buddhiheshan/aes-accelerator/docs/presentation.pdf

# RISC-V Based AES

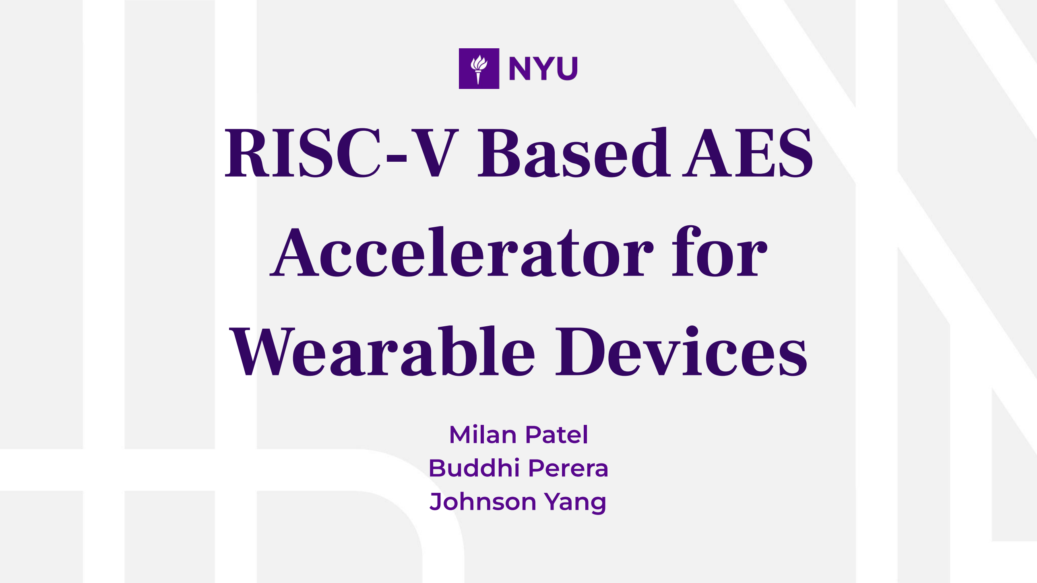
[picture p3: page 1]

# Accelerator for Wearable Devices

### Milan Patel Buddhi Perera Johnson Yang

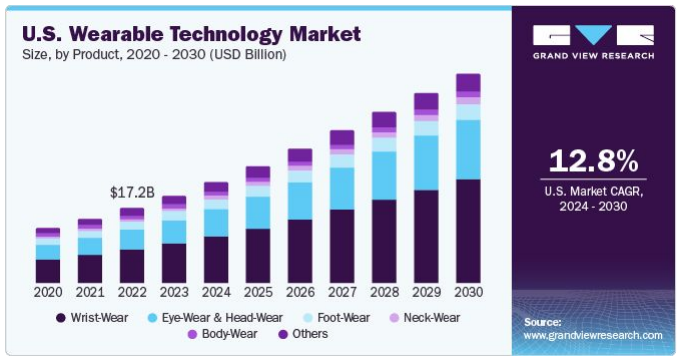
[picture p4: figure]

2

# Problem and Motivation

### - Wearable tech industry is rapidly growing [1] - High data throughput devices (e.g. smart watches or medical devices)

- Biometrics, audio, location, etc

### - Need for security!

- General purpose CPU is inefficient at encoding or decoding
- Application specific integrated chips can be more efficient
[1] Grand View Research, "U.S. Wearable Technology Market Size, Share & Trends Analysis Report By Product, By Application, By Distribution Channel, And Segment Forecasts, 2024 - 2030," Rep. GVR-1-68038-791-7, 2024. [Online]. Available: https://www.grandviewresearch.com/industry-analysis/us-wearable-technology-market-report.

# Solution - AES Accelerator

### - Memory mapped AES accelerator for encryption and decryption

- Write key and plain text/cipher text to the accelerator
- Start the the encryption/decryption
- Read the encrypted/decrypted values from accelerator
- Wearable devices → strict constraints on power and area.

### - Benefits

- Less clock cycles (than software implementations)
- Less power

### - Drawbacks

- More area

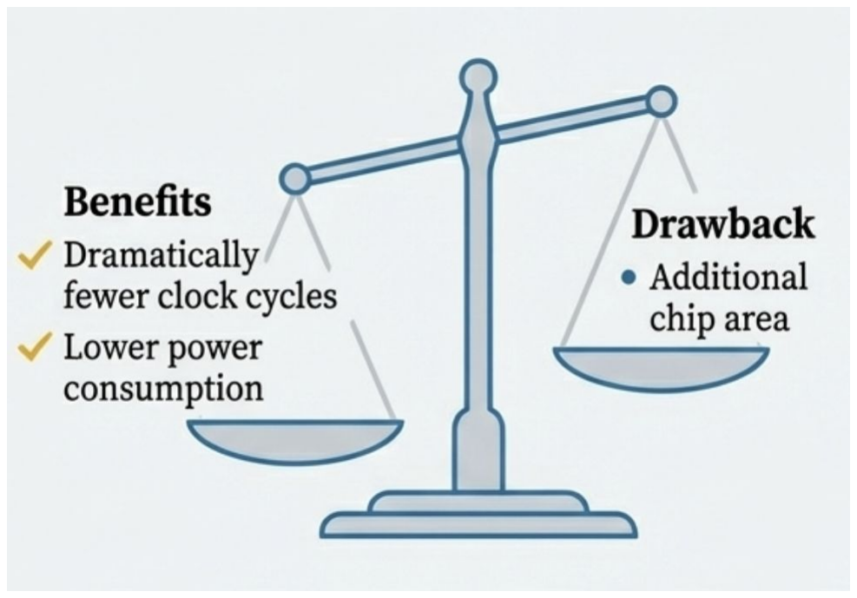
[picture p5: figure]
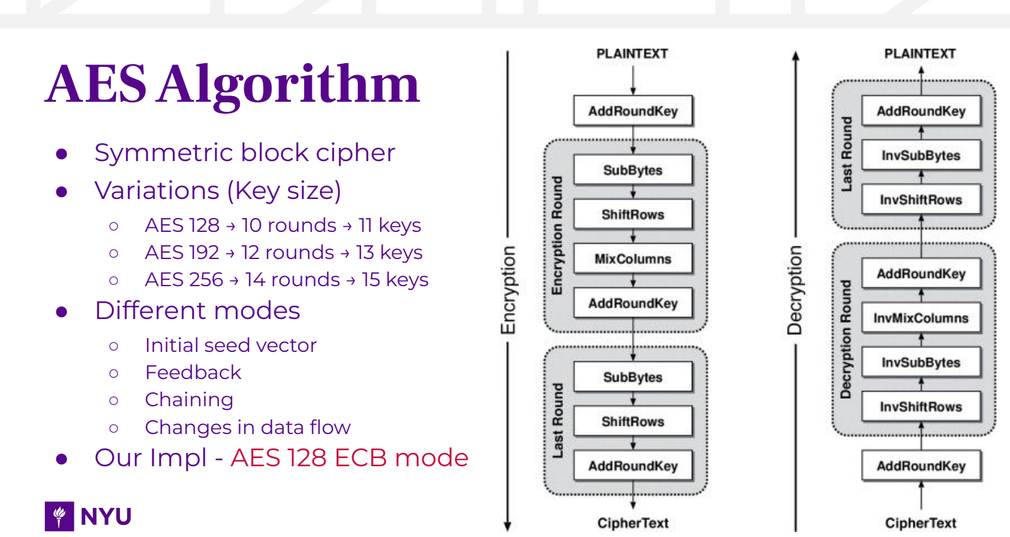
[picture p6: page 4]

4

AES Algorithm ● Symmetric block cipher ● Variations (Key size) ○ | AES 128 → 10 rounds → 11 keys ○ | AES 192 → 12 rounds → 13 keys ○ | AES 256 → 14 rounds → 15 keys ● Different modes ○ | Initial seed vector ○ | Feedback ○ | Chaining ○ | Changes in data flow ● Our Impl - AES 128 ECB mode

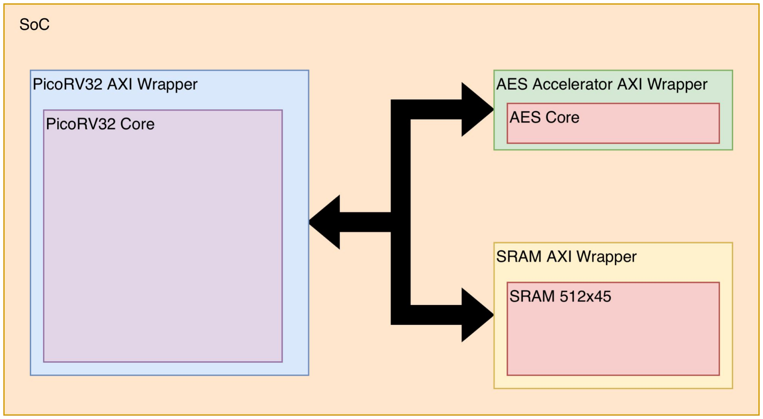
[picture p7: figure]

5

Overall Architecture ● CPU - PicoRV32 ○ | Open source IP by YosysHQ ○ | 32 bit single stage core ○ | RV32I instruction set ● SRAM ○ | TSMC SRAM macro 2kB ○ | SRAM AXI Wrapper in

SystemVerilog
- AES Accelerator ○ | Written in SystemVerilog ● Interconnect ○ | AXI4 Lite interface ○ | Memory mapped IO

# AES Accelerator

### - 3 cycles per round - 30

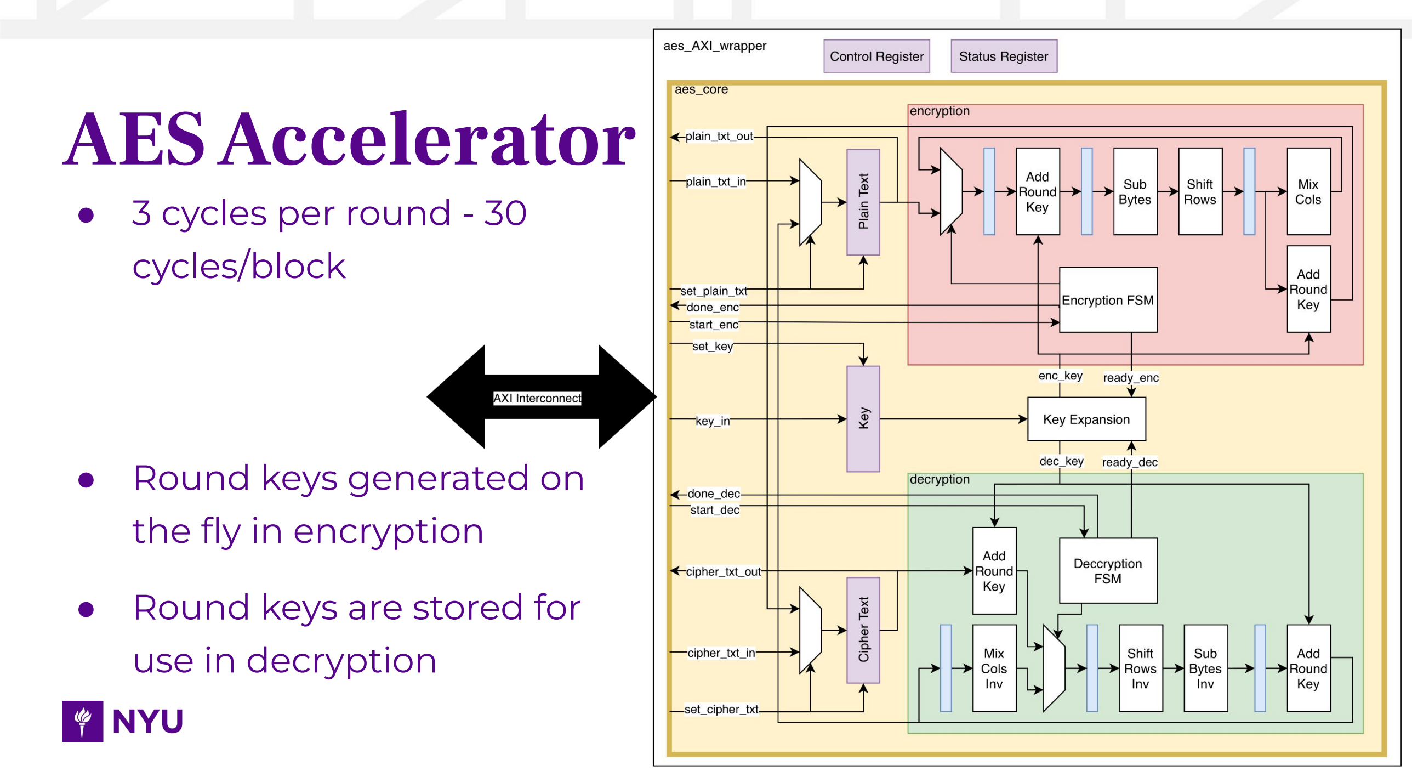
[picture p8: page 6]

6

### cycles/block

### - Round keys generated on the fly in encryption

### - Round keys are stored for use in decryption

# Verification - AES

### - RTL Waveform simulations

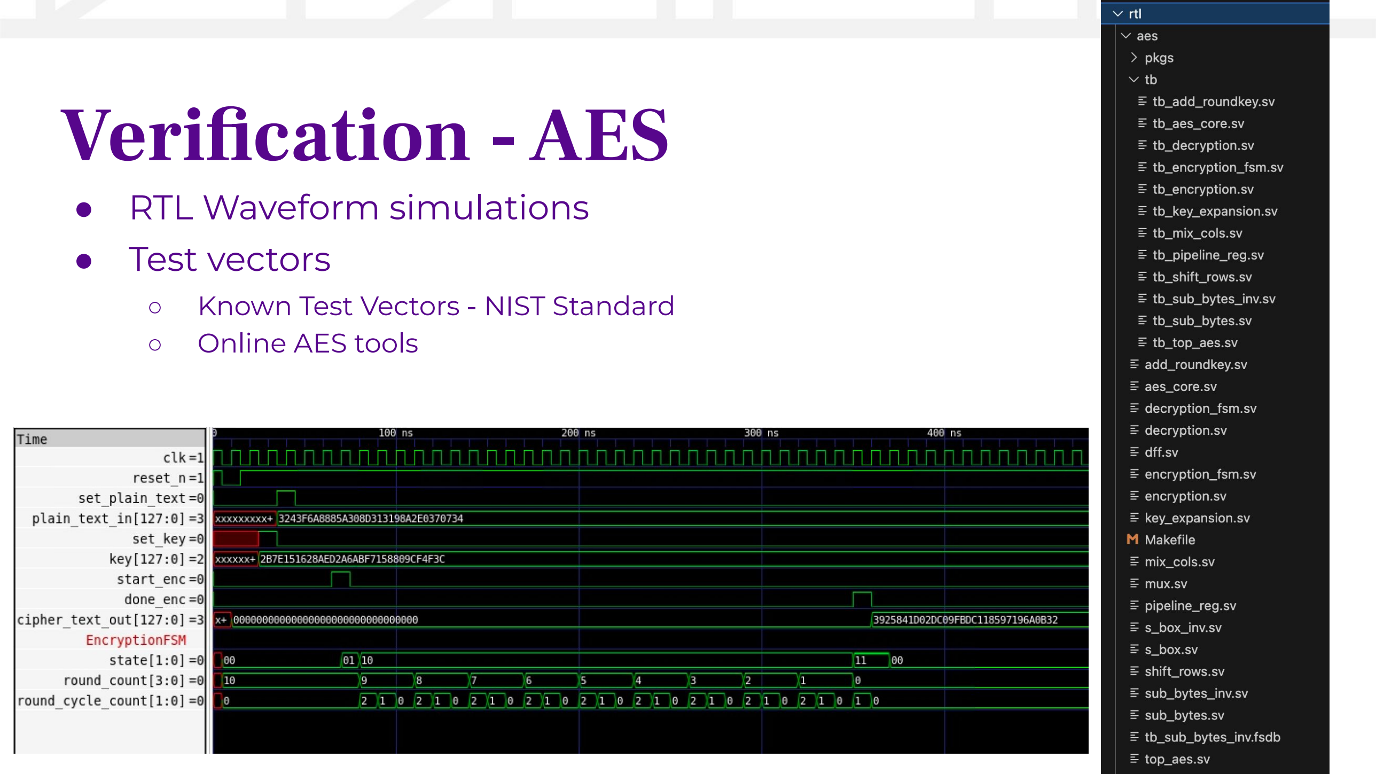
[picture p9: page 7]

7

### - Test vectors

- Known Test Vectors - NIST Standard
- Online AES tools

7

8

# Verification - CPU & SRAM via AXI

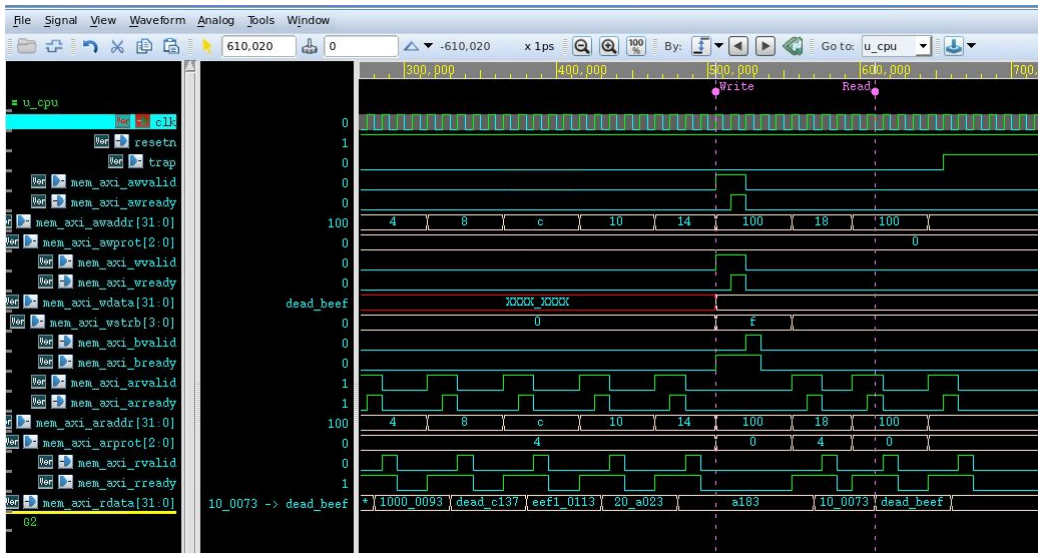
[picture p10: figure]

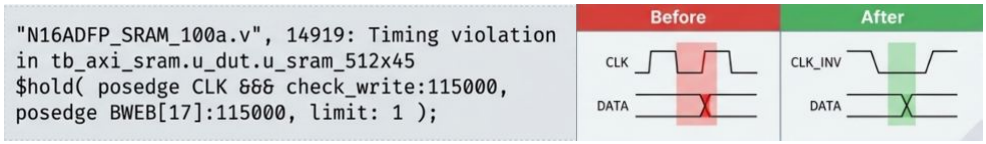
[picture p11: figure]

9

# Challenges - SRAM

- The SRAM Verilog model triggered timing assertions and error messages verilog model for timing violations, as the data signals were changing too close to the sampling edge during the half-cycle access.
- Fix: Implemented an inverted clock for the SRAM to strictly define the phase relationship between the CPU and memory, ensuring the signals remained stable long enough to satisfy the model’s hold-time requirements.

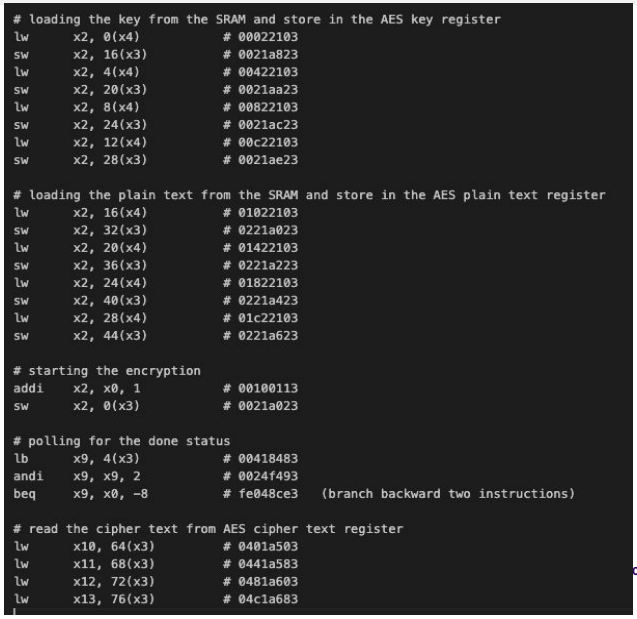
[picture p12: figure]

10

# Verification -SoC

### Encryption

# Verification - Writing Key and Plain text

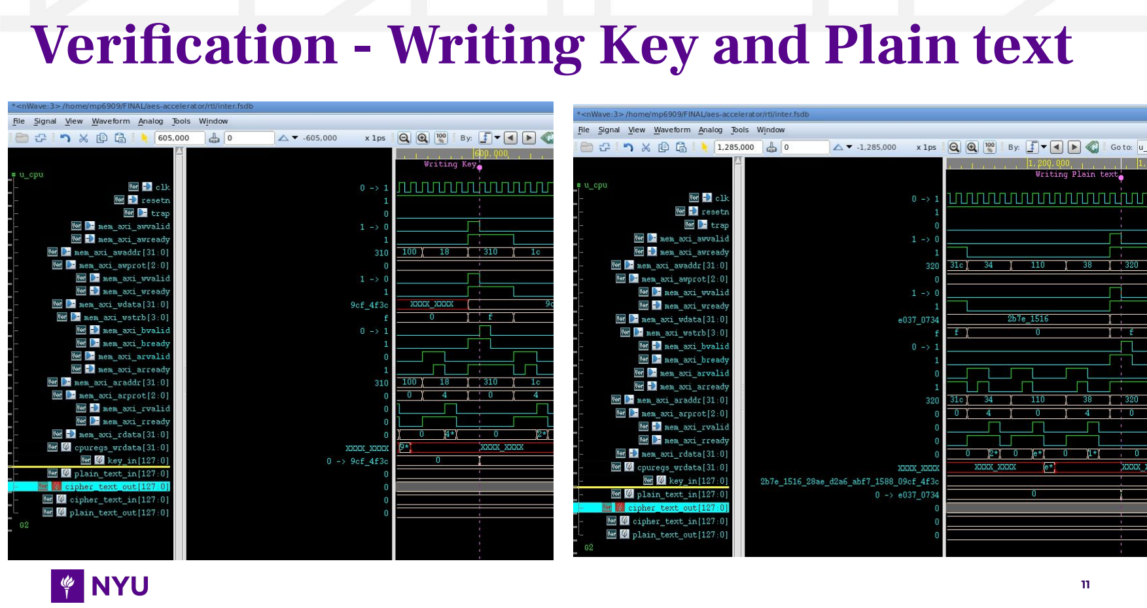
[picture p13: page 11]

11

# Verification - Encryption

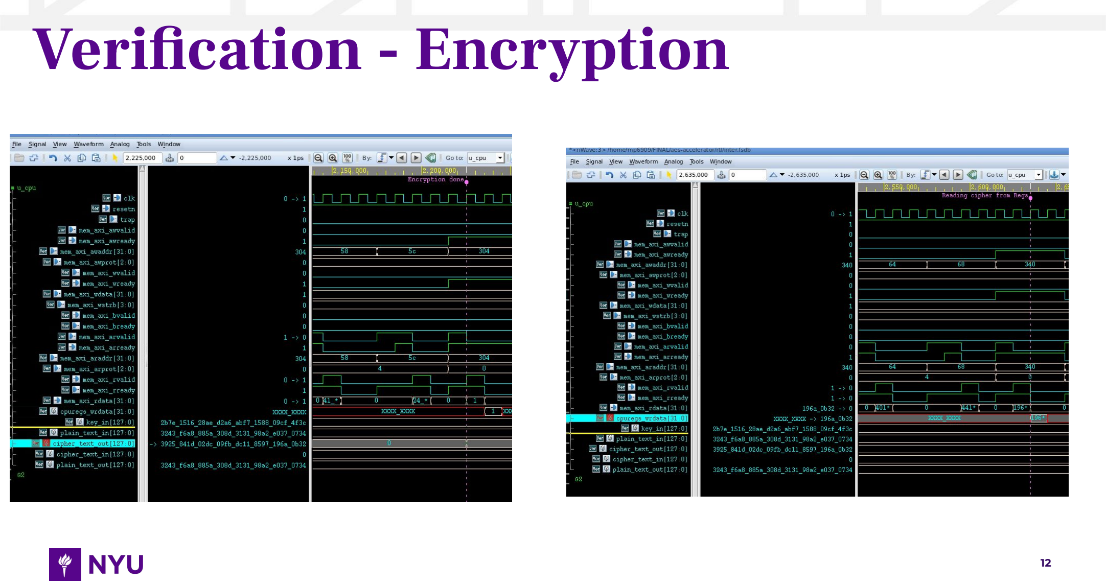
[picture p14: page 12]

12

# Verification - SoC

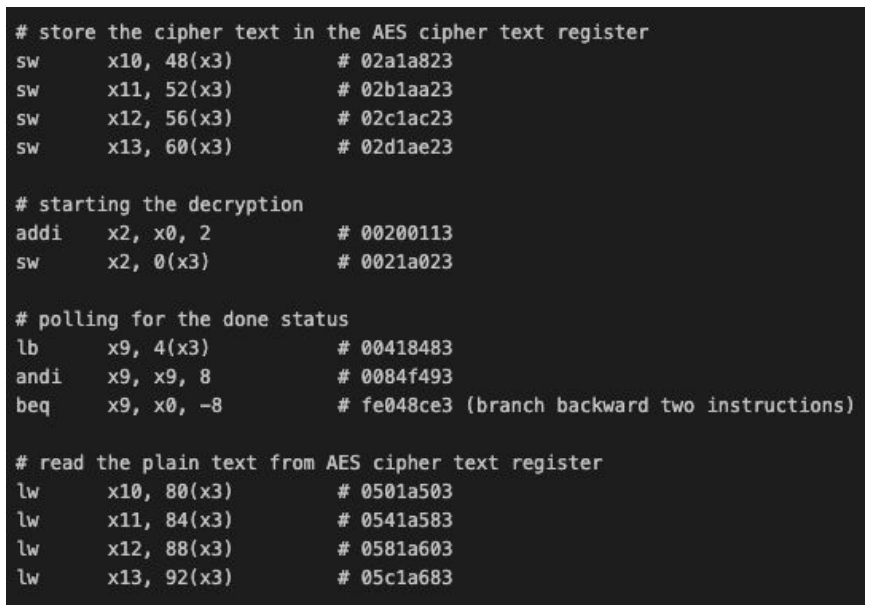
[picture p15: figure]

### Decryption

# Verification - Top Module (Decryption Waveform)

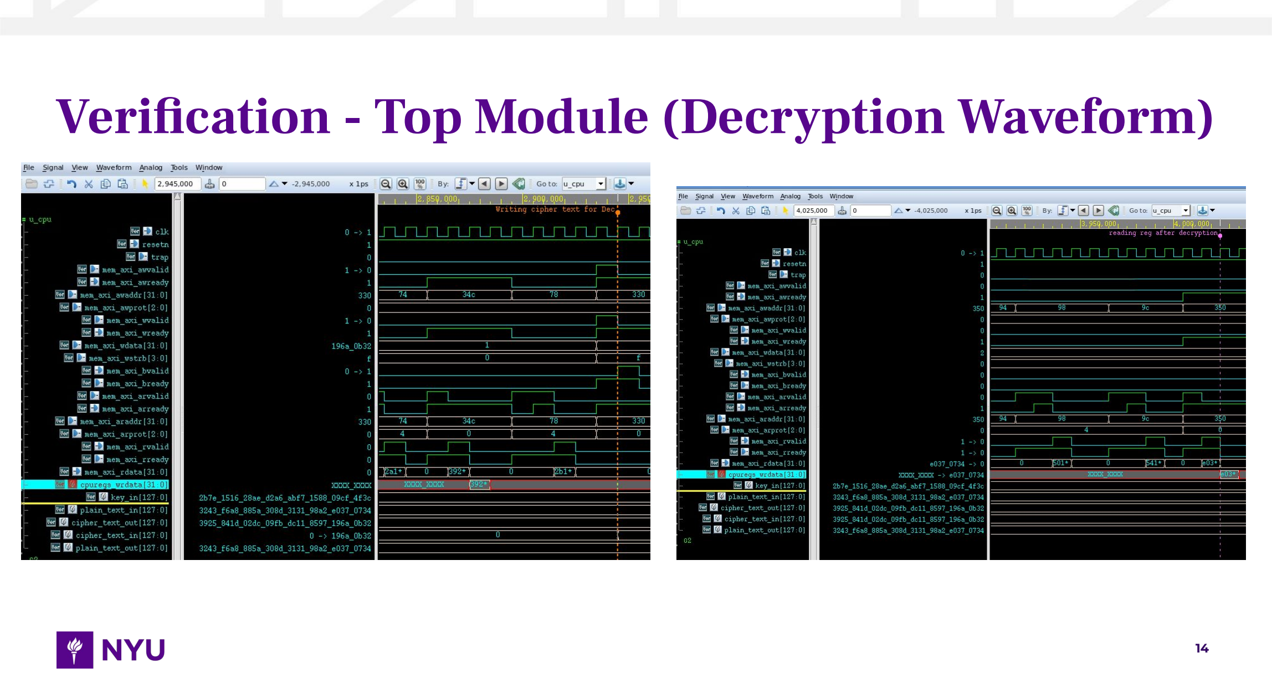
[picture p16: page 14]

14

15

# Evaluation – Targets

### - Chip Area: 4.5mm²

- 3.8mm²
(RISC-V CPU)
- 0.2mm²
(AES Accelerator)
- 0.5mm²
(SRAM)

### - Average Power: 5mW [1] - Cycles to Encrypt Plain Text: 340 for key expansion & 912 for encryption of 16-byte block [2]

- Benchmarked with RISC-V 32-bit 5-stage pipelined CPU
- Using optimizations in software based on [3]
[1] A. Dementyev, S. Hodges, S. Taylor, and J. R. Smith, "Power consumption analysis of Bluetooth Low Energy, ZigBee and ANT sensor nodes in a cyclic sleep scenario," in 2013 IEEE International Wireless Symposium (IWS), Beijing, China, 2013, pp. 1–4, doi: 10.1109/IEEE-IWS.2013.6616827.
[2] K. Stoffelen, "Efficient Cryptography on the RISC-V Architecture," Cryptology ePrint Archive, Paper 2019/794, 2019. [Online]. Available: https://eprint.iacr.org/2019/794
[3] Daniel J. Bernstein and Peter Schwabe. New AES software speed records. In Dipanwita Roy Chowdhury, Vincent Rijmen, and Abhijit Das, editors, Progress in Cryptology - INDOCRYPT 2008: 9th International Conference in Cryptology in India, volume 5365 of Lecture Notes in Computer Science, pages 322–336. Springer, Heidelberg, December 2008. 5

# Evaluation – Results

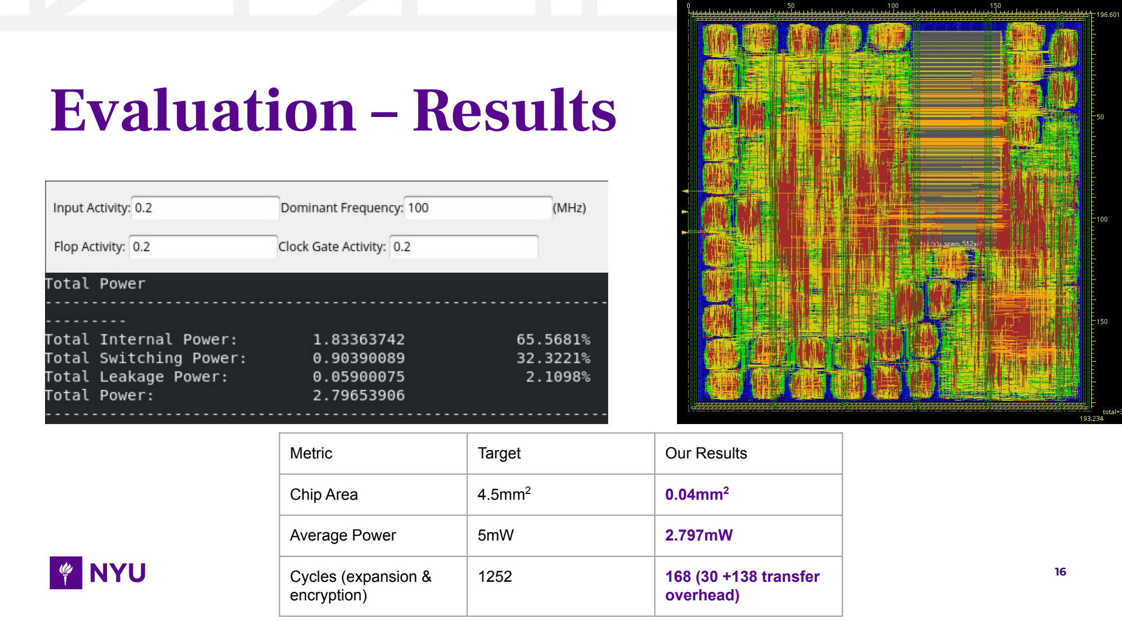
[picture p17: page 16]

Metric | Target | Our Results
Chip Area | 4.5mm² | 0.04mm²
Average Power | 5mW | 2.797mW
Cycles (expansion & encryption) | | | 16
1252 | 168 (30 +138 transfer overhead)

17

# Challenges –

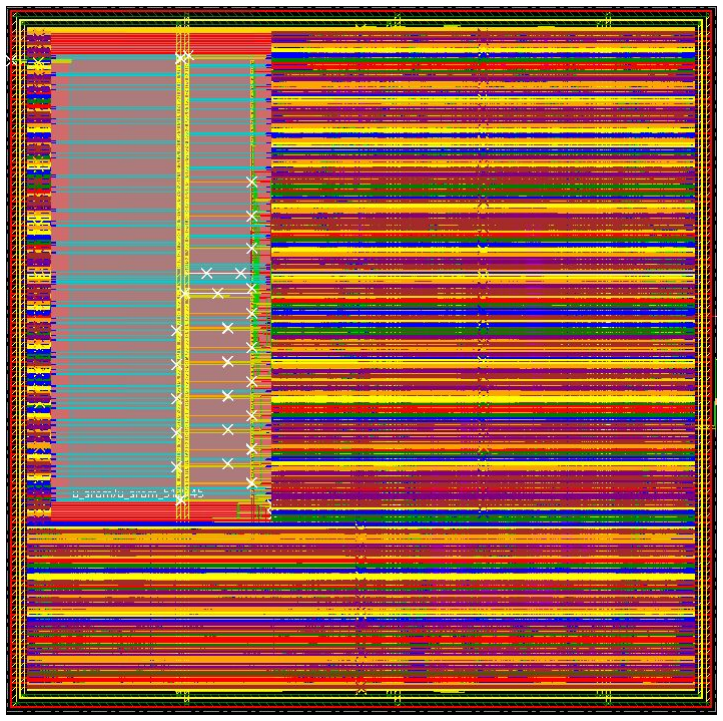
[picture p18: figure]

### LVS ● Passed DRC & STA but…

### thousands of LVS errors

- What We Tried? ○ | Alternate SRoute setups ○ | Testing multiple global net

connections
- Larger floorplan → More space for Vias/Wires
- Fillers → cover gaps to fill in open violations

# Challenges - Macros

### - Proper Connection to Macros

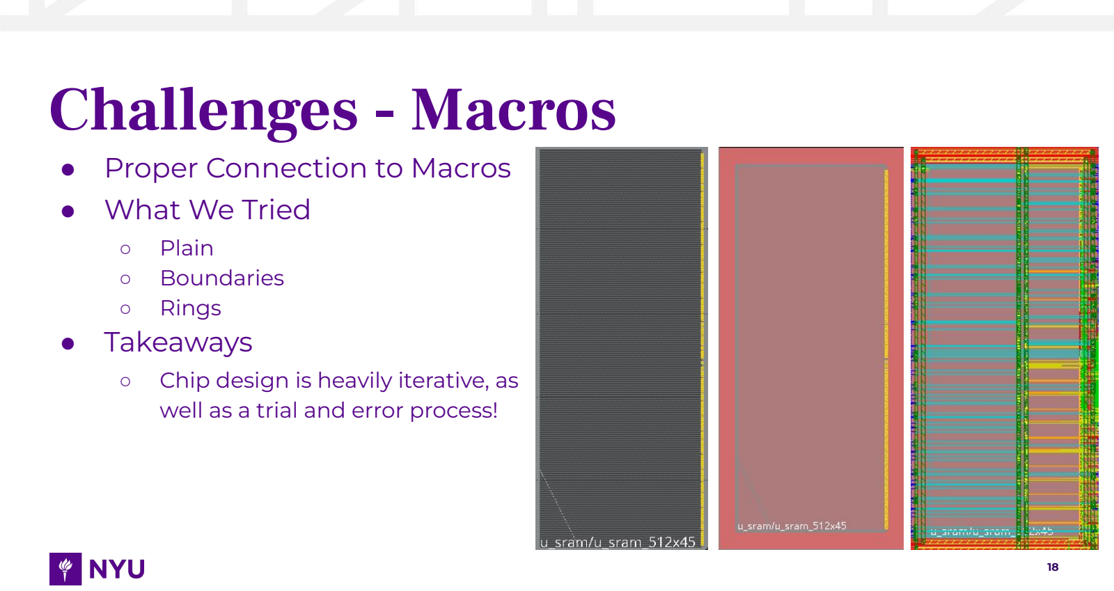
[picture p19: page 18]

18

### - What We Tried

- Plain
- Boundaries
- Rings

### - Takeaways

- Chip design is heavily iterative, as well as a trial and error process!

19

# Use of Generative AI in the Design Flow

### - Survey and analyze the possible design techniques

- Memory mapped vs tightly coupled ISA extension

### - Developing RTL code

- AXI interfaces
- AES submodules
- Comprehensive testbenches

### - Not as helpful in physical design

- Nonexistent commands or
wrong syntax
What Worked? | What Didn’t?

20

# Conclusion

### - Takeaways

- Our hardware based solution outperformed the software implementations
- Necessity of open-source material (PicoRV-32)
- Agile works!

### - Experiences

- Learning how to design hardware for accelerators
- Interconnecting peripherals in a SoC (Memory mapping)
- Hands on experience with EDA tools (Genus, Innovus, Calibre, etc)

### - Future work

- Fix LVS in the current design associated with the macros
- Configurable for different key sizes (192 and 256 key sizes)
- Support other AES modes

Q&A
