buddhiheshan/aes-accelerator/docs/additional_report.pdf

## RISC-V-based AES Accelerator for Wearable Devices

Milan Patel, Buddhi Perera, and Johnson Yang

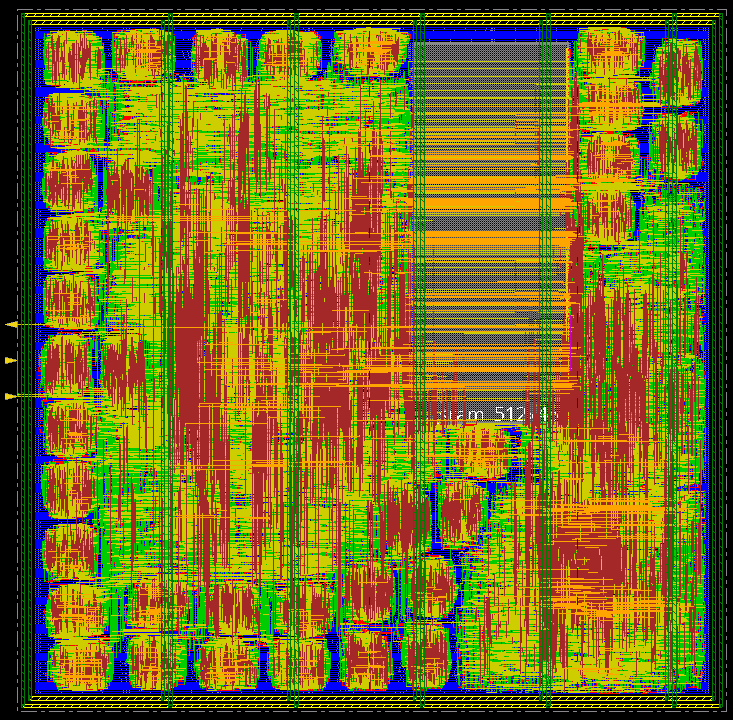
[picture p20: figure]

Figure 1. Chip layout through Innovus GUI depicting a SRAM macro on the upper right, and standard cells used in the netlist of the AES module and PicoRV32 core. The surrounding power ring uses vertical layer m11 and horizontal layer m10, power stripes provide power/ground to our macro and routes on each row do the same for our standard cells, fillers, and taps.

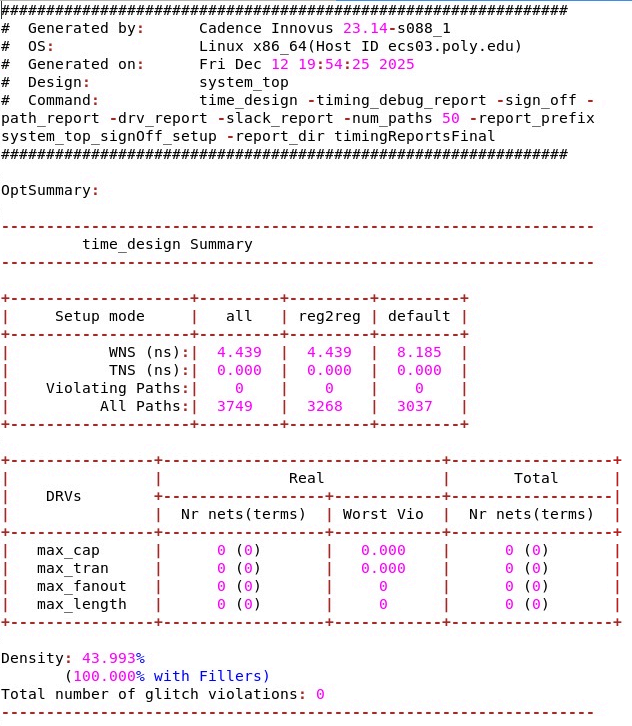
[picture p21: figure]

Figure 2. Setup timing report indicating our chip has no violating paths and passes design rule violation checks. This report uses the sign-off option of the time_design command, with the command shown at the top.

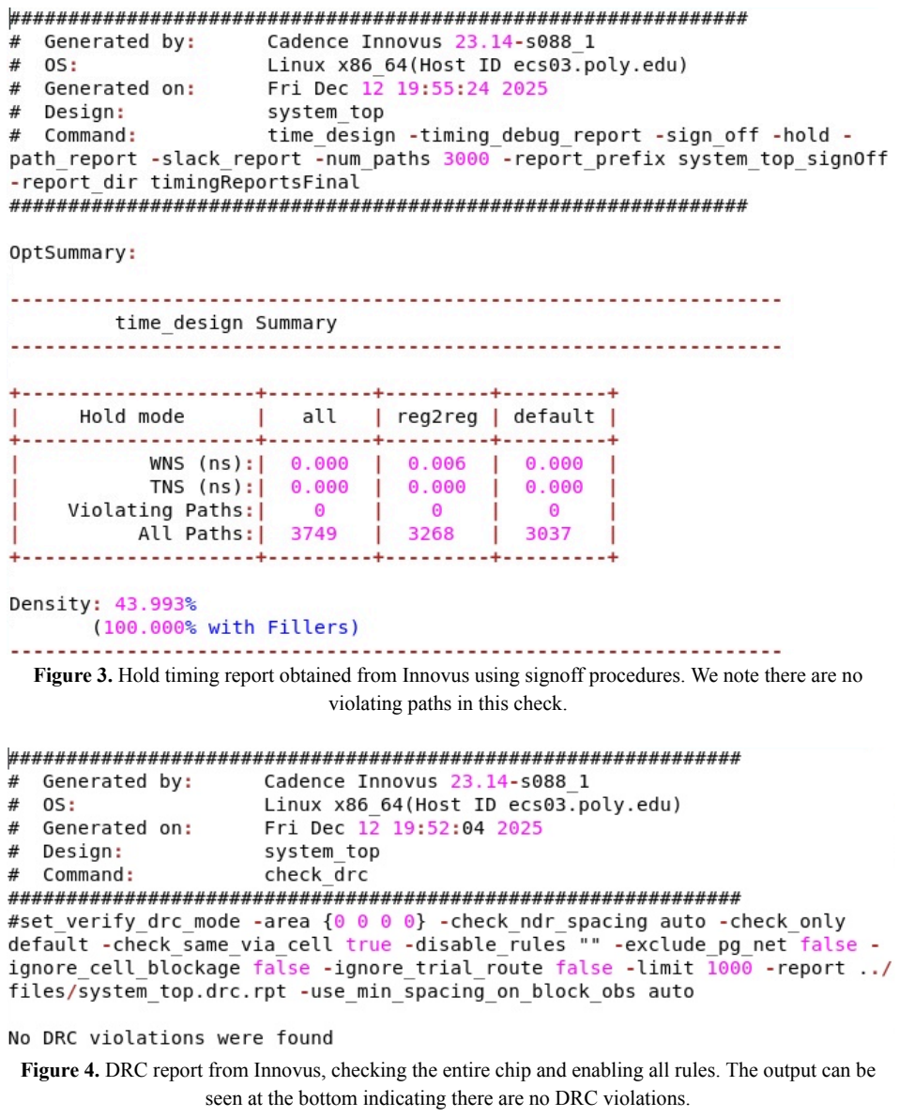
[picture p22: page 3]

Figure 3. Hold timing report obtained from Innovus using signoff procedures. We note there are no violating paths in this check.

Figure 4. DRC report from Innovus, checking the entire chip and enabling all rules. The output can be seen at the bottom indicating there are no DRC violations.

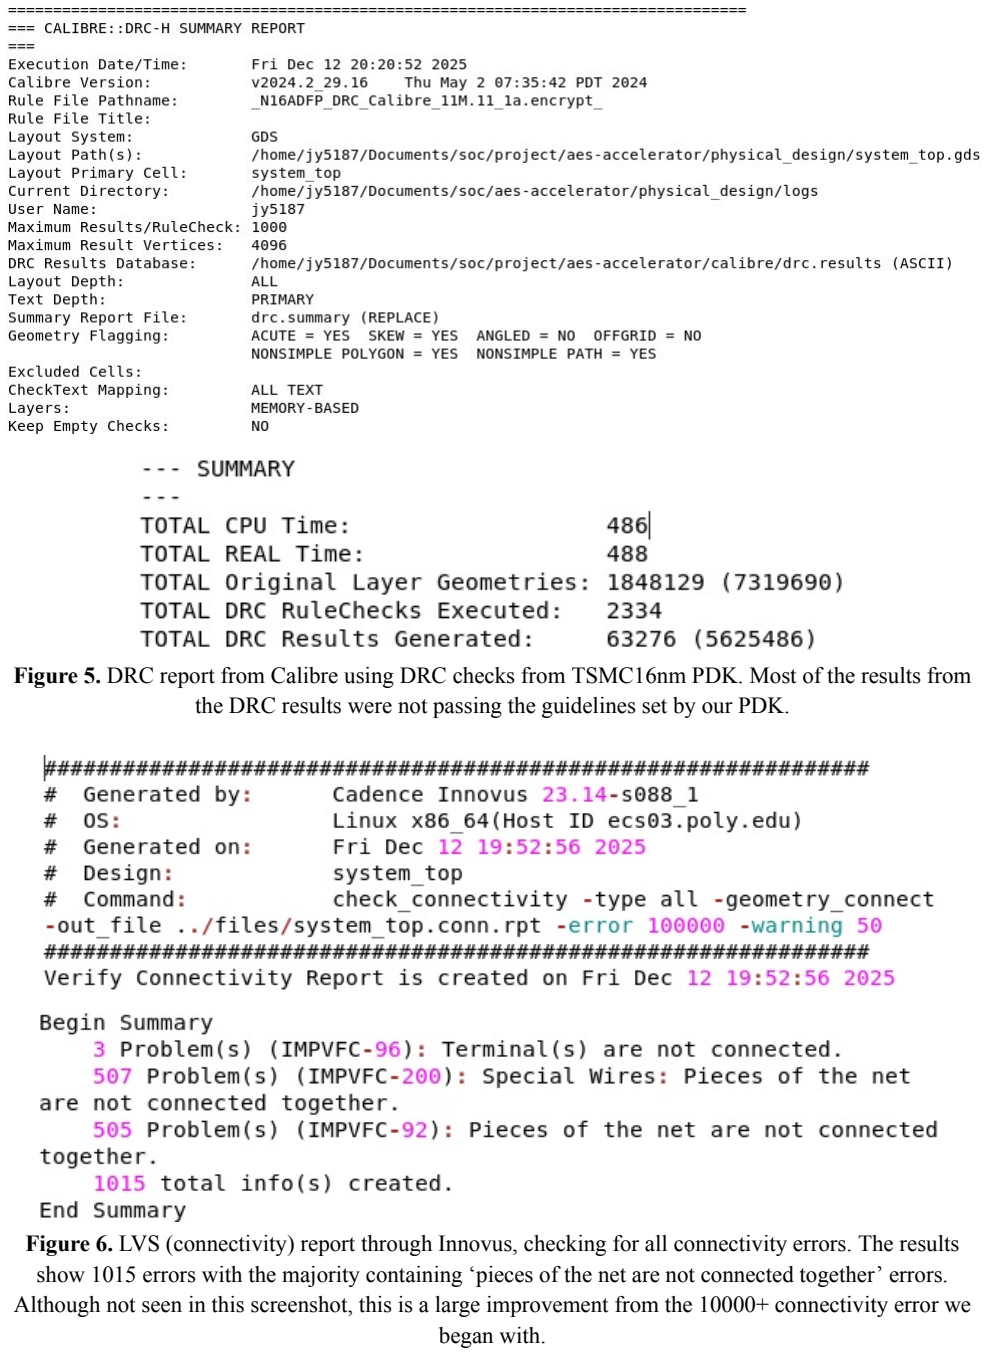
[picture p23: page 4]

Figure 5. DRC report from Calibre using DRC checks from TSMC16nm PDK. Most of the results from the DRC results were not passing the guidelines set by our PDK.

Figure 6. LVS (connectivity) report through Innovus, checking for all connectivity errors. The results show 1015 errors with the majority containing ‘pieces of the net are not connected together’ errors. Although not seen in this screenshot, this is a large improvement from the 10000+ connectivity error we began with.

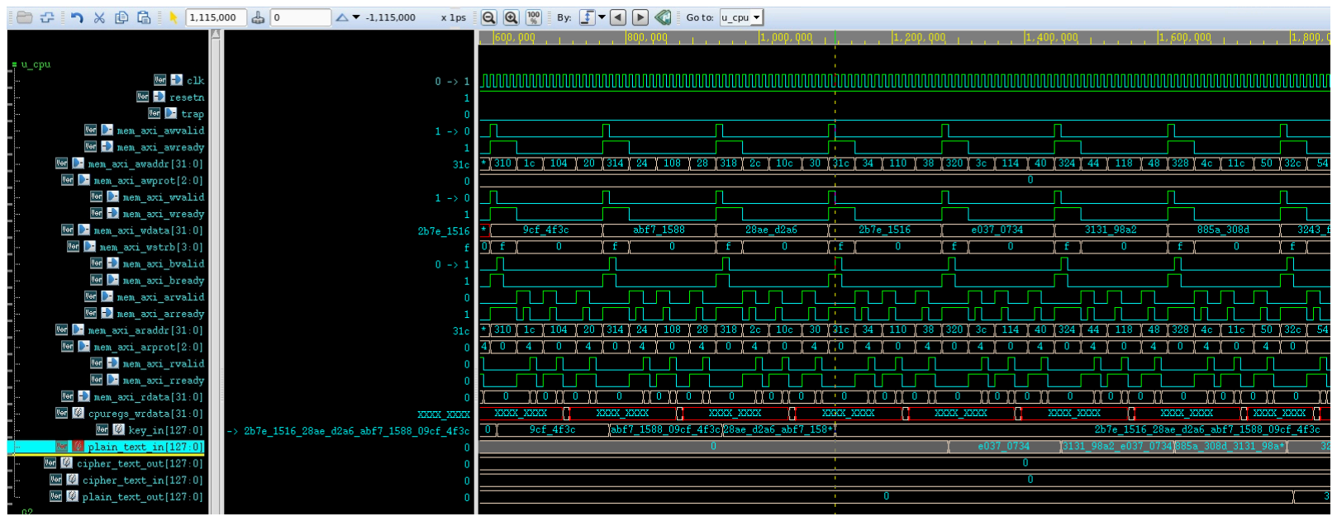
[picture p24: figure]

Figure 7. The waveform shows how the key is being written into our AES registers from the CPU. Because our key is 128bits but our AXI module is only 32 bits, we must perform four store operations to write all 128 bits of the key. The first is written to address 0x310 (time 600,000), after our main module (CPU) asserts address/data is valid while the sub module (AES) asserts it is ready to receive the address/data. The next address is 0x314, followed by 0x318 and finally ending at 0x31c. We can see key_in incrementally filling in by 32 bits on each of those intervals.

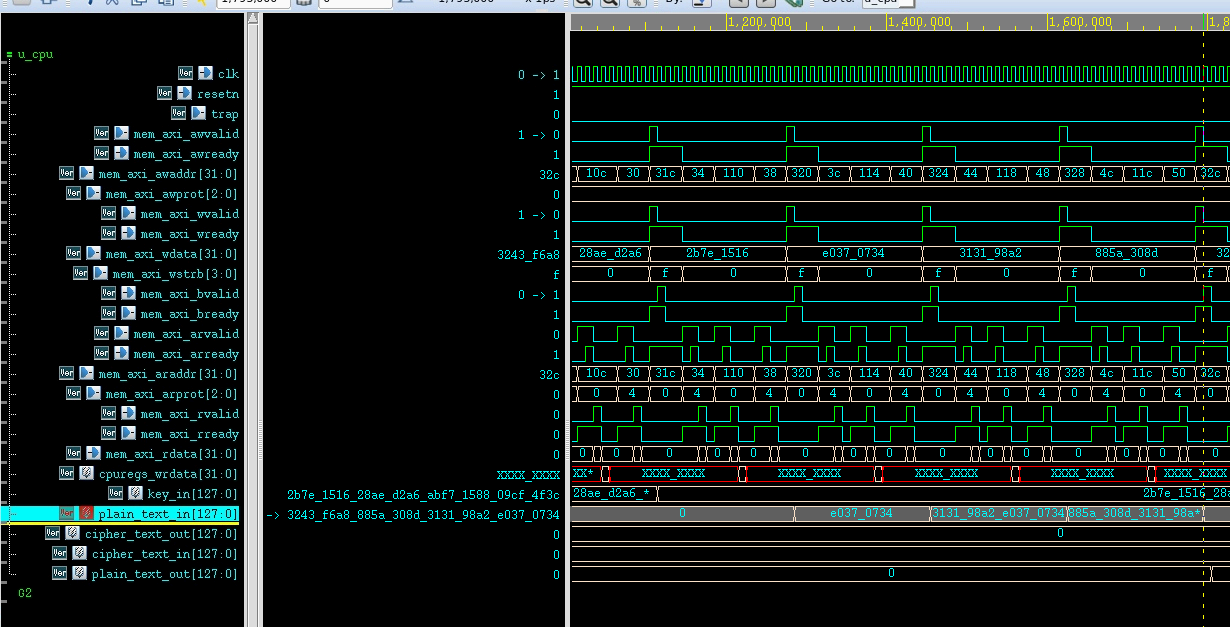
[picture p25: figure]

Figure 8. Depiction of the first half of encryption in which we write the plain text from the CPU into AES registers, following a similar procedure to writing key_in. We note the AES registers holding the plain_text are located at address 320, 324, 328 and 32c. Around 1,800,000ns all 128 bits of our plain_text are entered and encryption is ready to start.

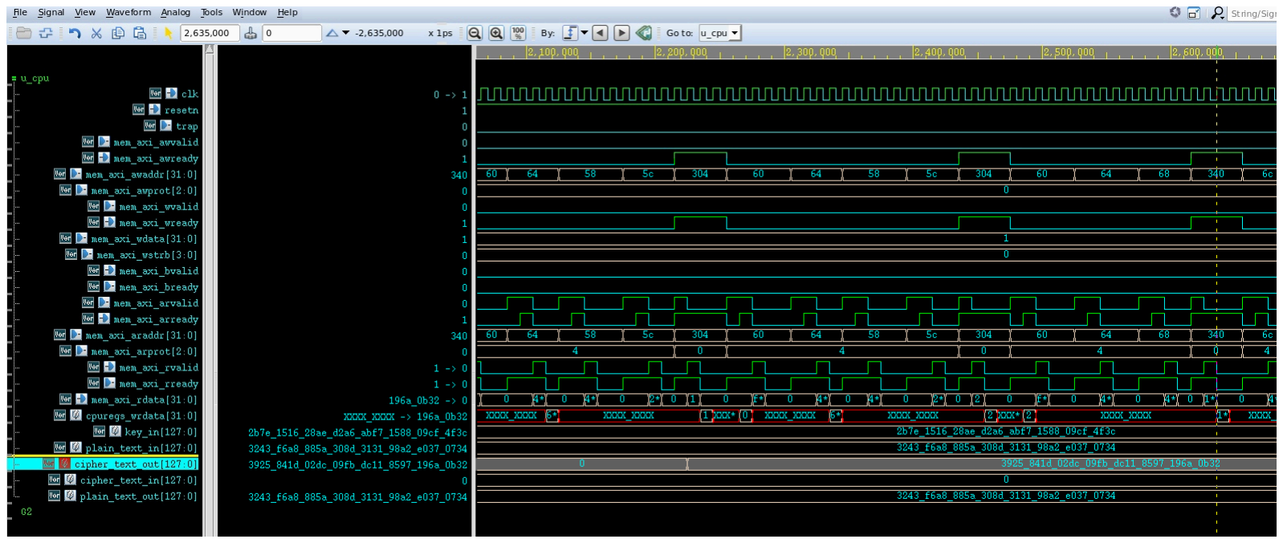
[picture p26: figure]

Figure 9. Depiction of the second half of encryption in which the CPU reads the encrypted cipher_text from the AES module. In the waveform above, the cipher_text is finished computing at approximately 2,200,000ns when the register value changes from 0 to 128bit. For the CPU to read the 128bit cipher_text, it must be done in four 32-bit operations which occur when read address/data signals are asserted by the CPU. These four read operations are into addresses 340, 344, 348 and 34c starting around time 2,600,000ns.

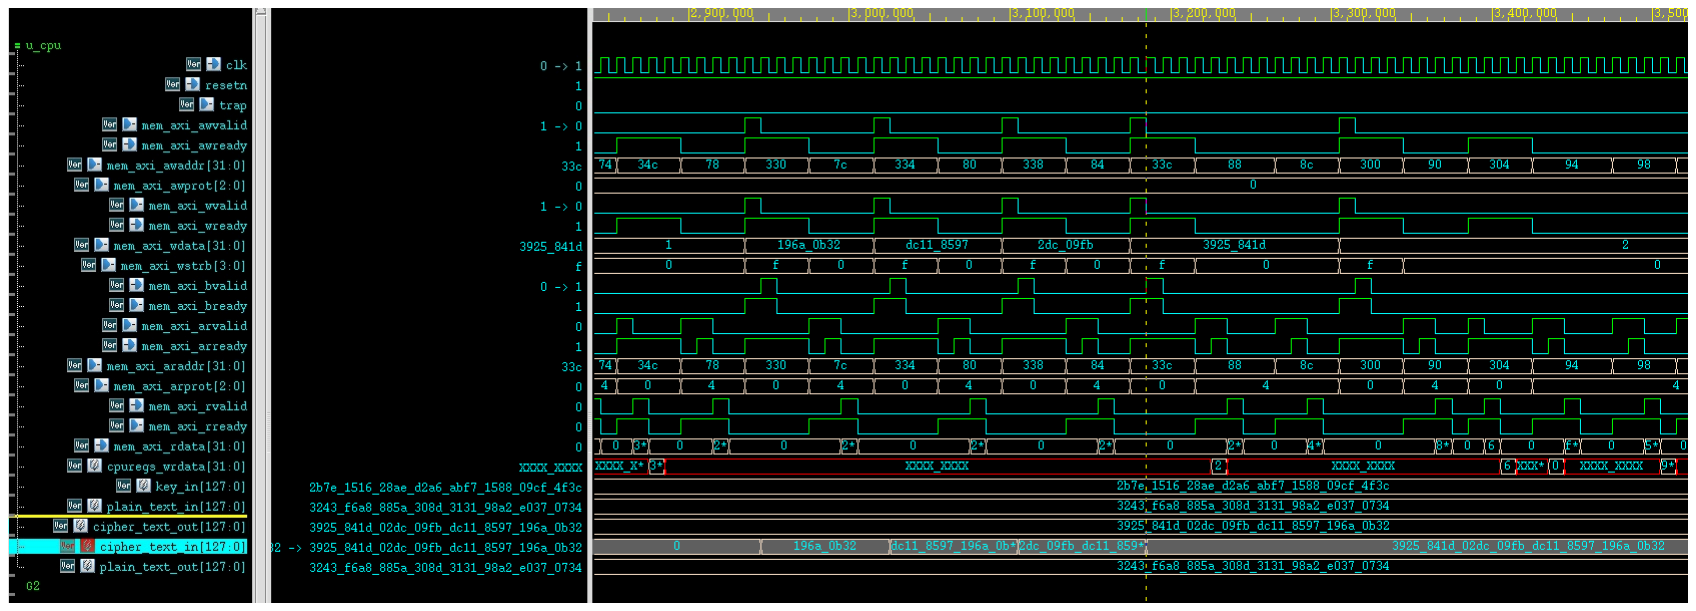
[picture p27: figure]

Figure 10. The waveform shows the first half of decryption, in which we write a cipher text from the CPU into the AES module. The key input for decryption is not shown above, but is exactly the same as the key input for encryption reflected in fig. 7. The addresses for the cipher text inputs are at 330, 334, 338 and 33c, and at those respective intervals, the cipher_text_in register becomes populated with data from the CPU.

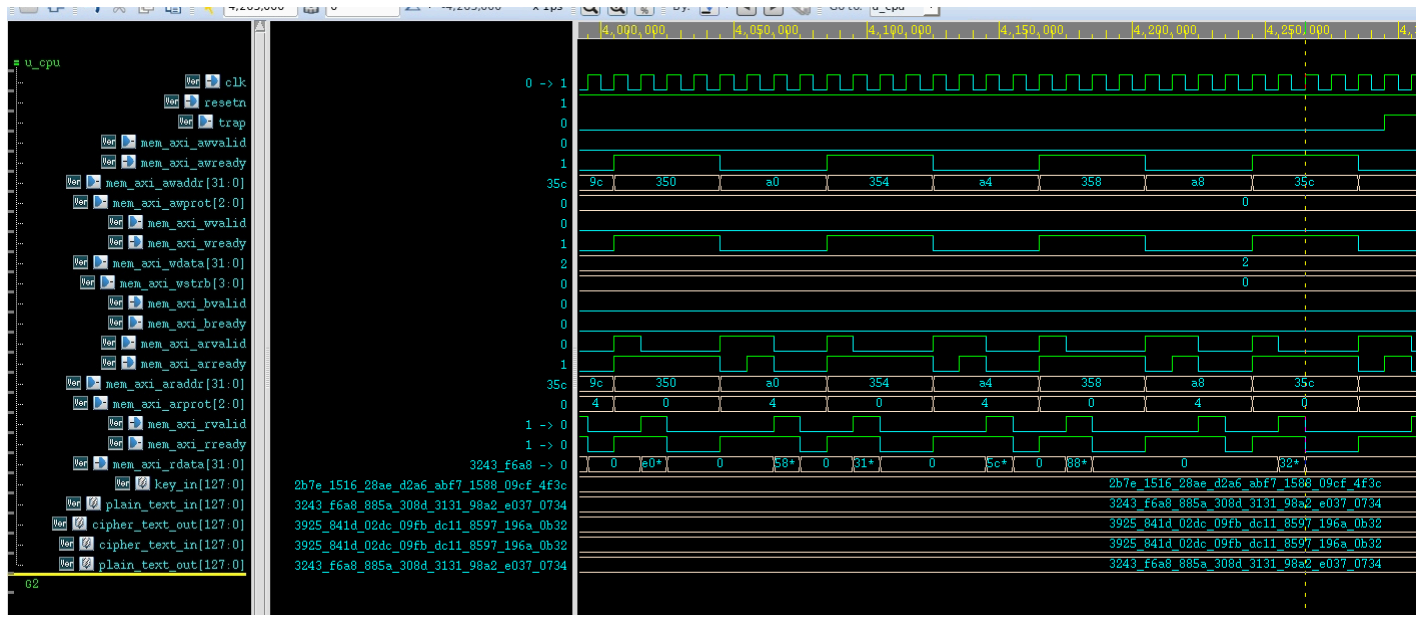
[picture p28: figure]

Figure 11. The waveform shows the second half of decryption, in which the CPU reads the plain text output after it has been fully decrypted by our AES module. This process mirrors that of reading cipher text output in fig. 9. The respective addresses we are reading from, and where the plain text output is stored, is 350, 354, 358 and 35c. We verify the CPU is properly reading these values because the read valid signals are being asserted while the read ready signals are high.

Waveform Simulations of AES for Functional Verification

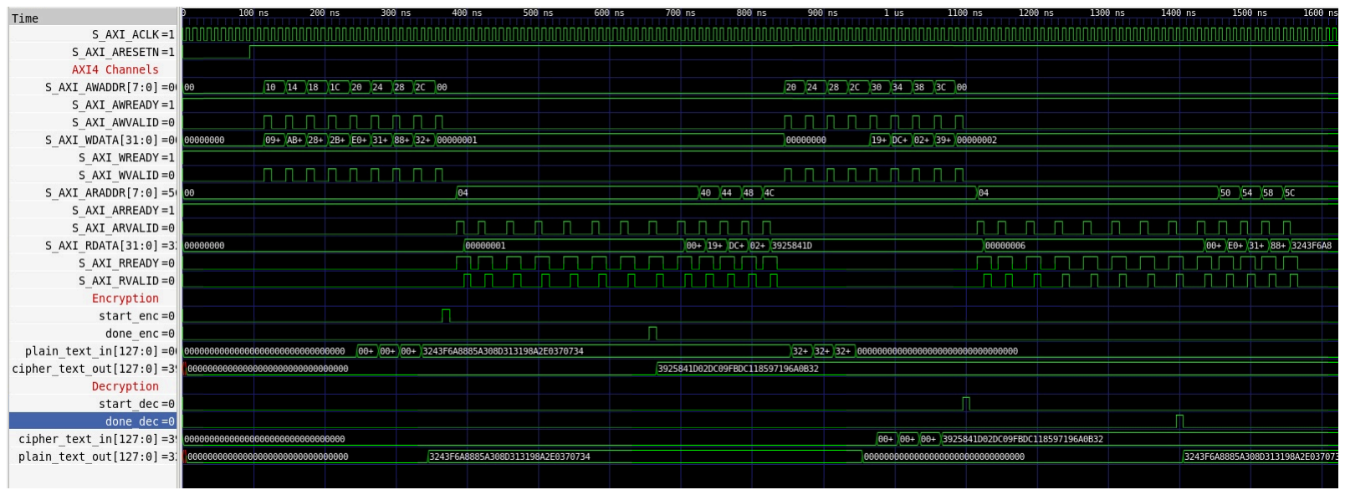
[picture p29: figure]

Figure 12. Waveform simulation of aes_axi_wrapper. The key and plain text is written during time ~100ns to ~400ns, encryption is occurring during time ~400ns to ~700ns, while decryption occurs from time ~1100ns to ~1400ns.

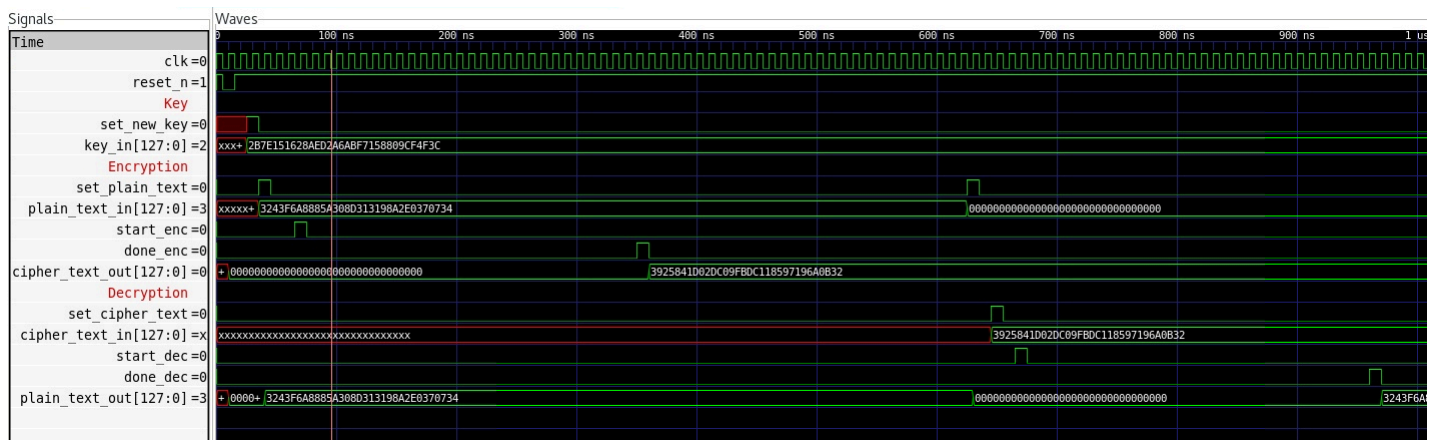
[picture p30: figure]

Figure 13. Waveform simulation of our aes core. Initializes when key and plain text is written in at once, encryption occurs when start_enc is asserted at ~100ns while it ends when end_enc is asserted at ~375ns. Meanwhile decryption occurs when start_dec is asserted at ~700ns and is completed when done_dec is asserted at ~1000ns.

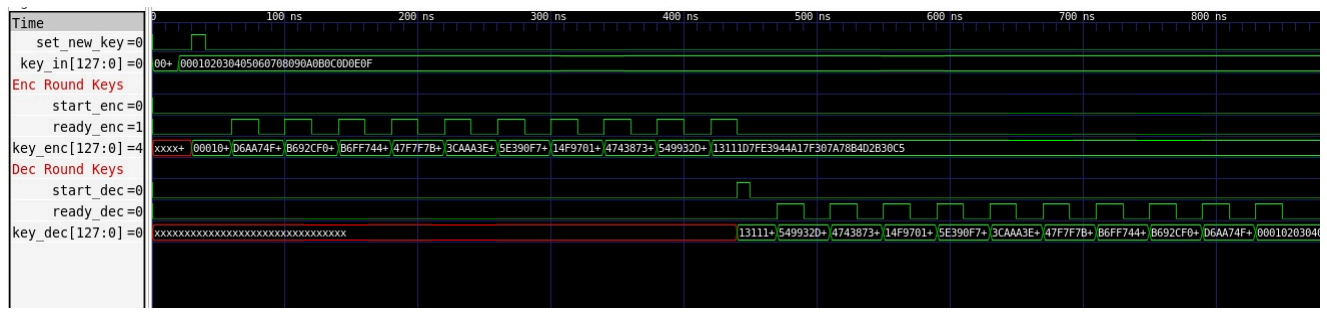
[picture p31: figure]

Figure 14. Waveform simulation of key generation on the request from enc/dec fsm. A new key is generated on every assertion of ready_enc and ready_dec, and because our AES module does 10 rounds, we require 10 keys.

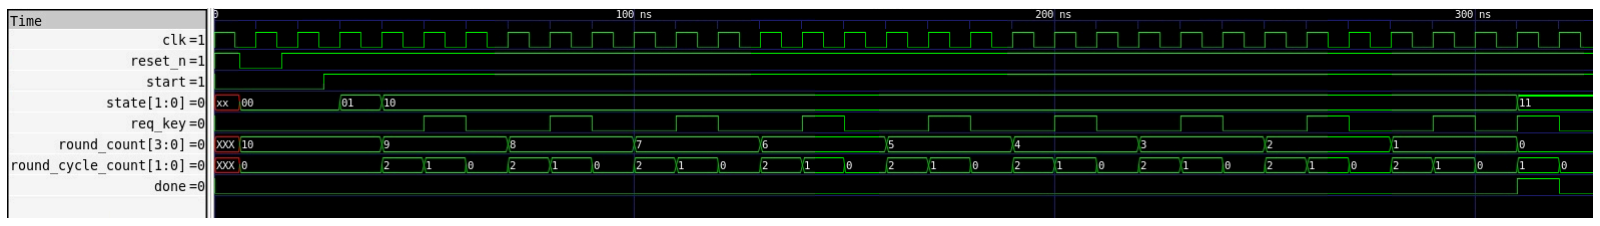
[picture p32: figure]

Figure 15. Encryption FSM - state changes, round counts and cycles per round and requesting encryption key.

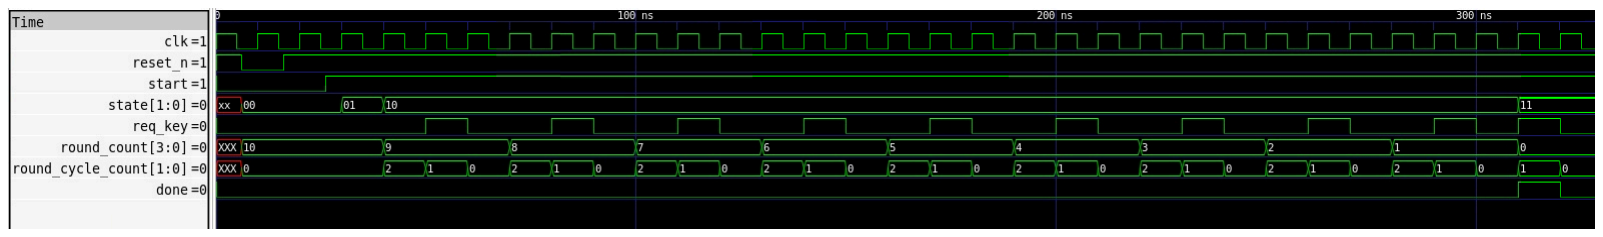
[picture p33: figure]

Figure 16. Decryption FSM - state changes, round counts and cycles per round and requesting decryption key.

## Additional Work

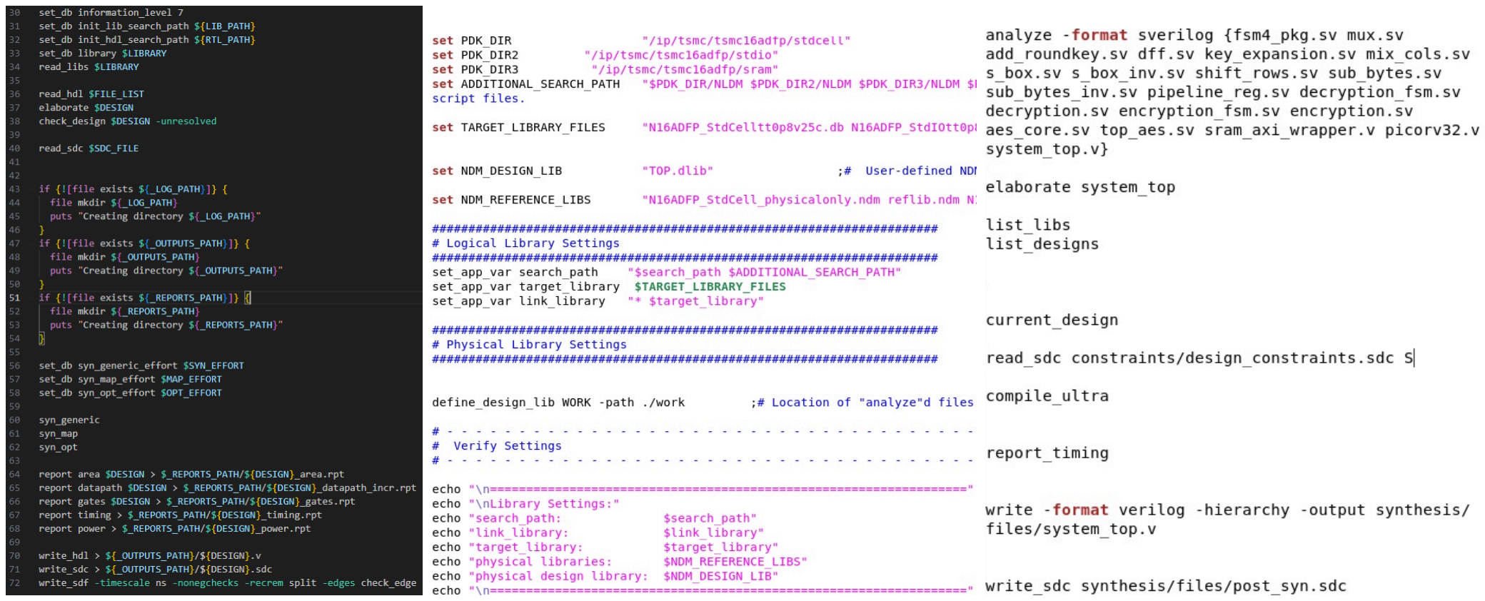
[picture p34: figure]

Figure 17. Scripts for genus(left), and design compiler(middle and right). By creating scripts we were able to generate netlists without using the UI for their respective tools, thus decreasing the time it took to process any RTL changes.

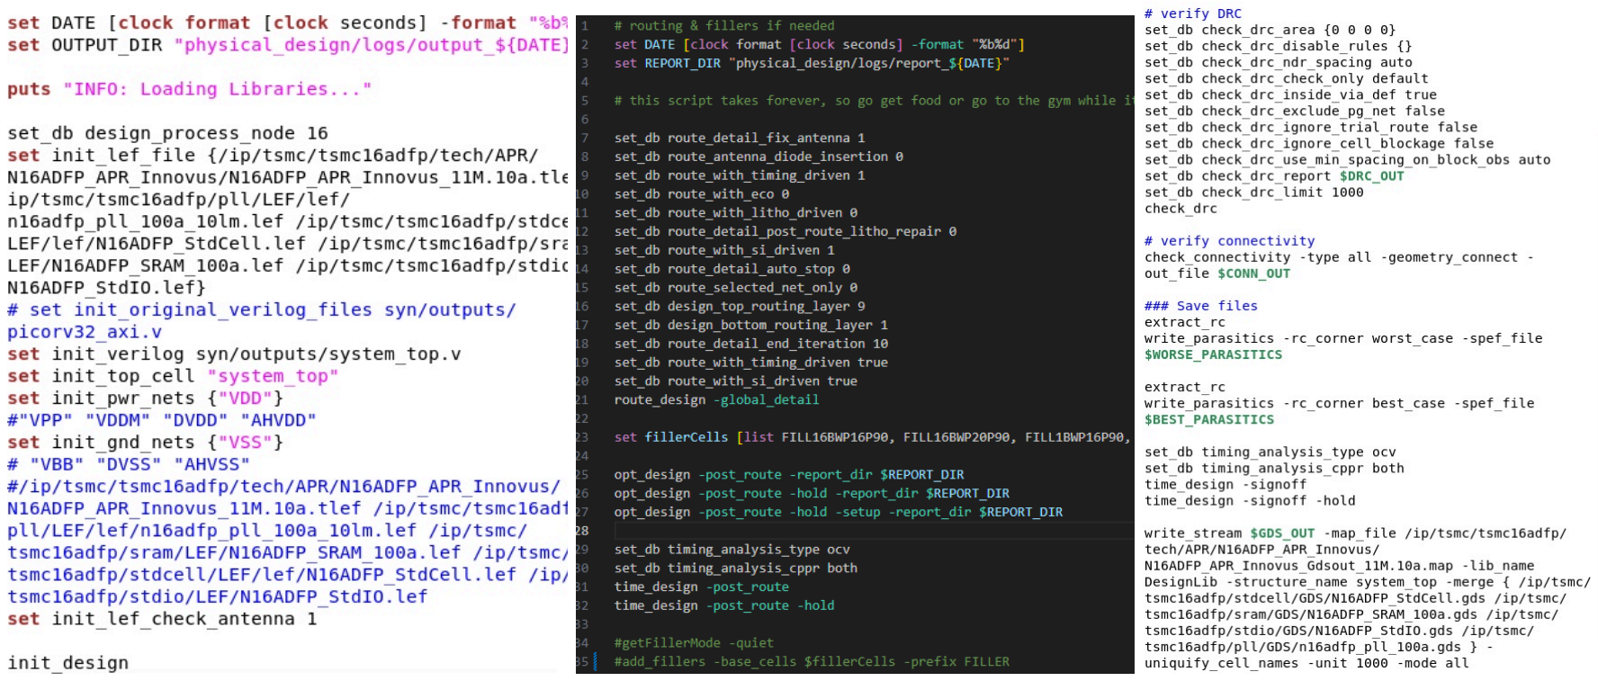
[picture p35: figure]

Figure 18. TCL scripts for different steps in Innovus including setup (left), detailed routing (middle), and generating GDS file (right). Additional scripts for steps such as floorplanning, and placement were also built but not shown above. These scripts for Innovus allowed us to automate the physical design process, facilitating less time between design changes to testing for DRC, LVS, and STA.

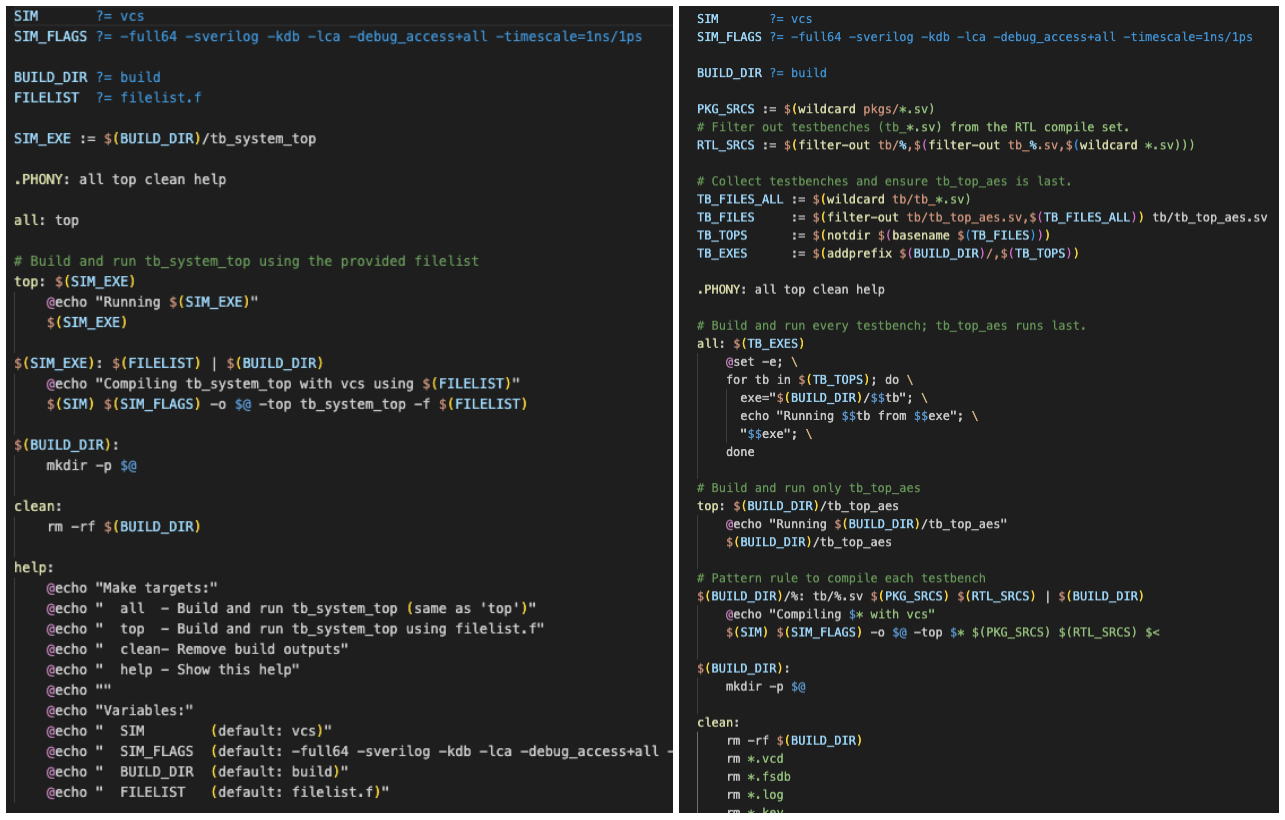
[picture p36: figure]

Figure 19. Shown above is a makefile which compiles all the verilog code instantiated by our top module (including CPU, SRAM, AES and AXI interconnect), and additionally builds and runs all our tests. Another makefile was created for testing AES functionality individually but not shown above. Through the makefile we were able to automate testing and verify the functionality of our modules quicker, reducing repetitive work.
