buddhiheshan/aes-accelerator/aes/tb/tb_top_encryption.sv

module tb_top_encryption;
timeunit 1ns/1ps;

logic [127:0] plain_text;
logic [127:0] key_in;
logic clk;
logic reset_n;
logic start;
logic restart;
logic set_new_key;
logic [127:0] cipher_text;

top_encryption dut(
    .clk(clk),
    .plain_text(plain_text),
    .key_in(key_in),
    .reset_n(reset_n),
    .start(start),
    .restart(restart),
    .cipher_text(cipher_text),
    .set_new_key(set_new_key)
);

initial begin
    $dumpfile("dump.vcd");  
    $dumpvars;
  end

always #5 clk = ~clk;

task check_output(logic [127:0] output_state, logic [127:0] expected_output_state);
        if (output_state !== expected_output_state) begin
            $display("FAILED: Output state missmatch!");
            $display("Expected: %h\nGot: %h", expected_output_state, output_state);
        end
        else $display("PASS");
endtask

initial begin
    clk = 1'b1;
    #6;
    set_new_key =1'b1;
    key_in = 128'h2b7e151628aed2a6abf7158809cf4f3c;
    #10;
    set_new_key =1'b0;

    plain_text = 128'h3243f6a8885a308d313198a2e0370734;
    
    reset_n = 1'b1;
    start = 1'b0;
    restart = 1'b0;
    #10;
    reset_n = 1'b0;
    #10;
    reset_n = 1'b1;
    #10;
    start = 1;
    #10;
    start = 0;

    #500;
    check_output(cipher_text, 128'h3925841d02dc09fbdc118597196a0b32);
$finish;

end
endmodule
