buddhiheshan/aes-accelerator/(commit log)

2025-12-01 Refactor key expansion module
    Refactor key expansion logic for clarity and correctness.
    [key_expansion.sv]
2025-12-02 Refactor ShiftRows logic and improve comments
    Updated the ShiftRows logic to include comments and fixed byte unpacking and packing to read from MSB to LSB.
    [shift_rows.sv]
2025-12-03 fixed packing and unpacking in mix columns
    [mix_cols.sv, tb_mix_cols.sv]
2025-12-08 added aes top with issues in decryption
    [aes_core.sv, decryption.sv, tb_aes_core.sv, tb_top_aes.sv, top_aes.sv]
2025-12-09 fixed the decryption data flow
    [decryption.sv, decryption_fsm.sv, tb_decryption.sv, tb_encryption.sv, tb_top_aes.sv]
2025-12-10 initializing integration branch, working on adding aes with the current CPU/SRAM config
2025-12-11 Buddhiheshan/aes core (#7)
    * Comment out key loading logic on set_new_key
    Commented out the always block for key loading on set_new_key signal.
    * Simplify key expansion reset conditions
    Refactor key expansion logic to remove redundant reset condition.
    * added synth scripts
    * done_enc fix
    ---------
    [key_expansion.sv, top_aes.sv]
2025-12-11 current working files
2025-12-11 Buddhiheshan/aes core (#10)
    * enc dec firmware
    * updated the enc dec firmware
    * fixed encryption fsm
    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
    [encryption_fsm.sv]
2025-12-11 Buddhiheshan/aes core (#11)
    * updated decruption fsm
    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
    [decryption_fsm.sv]
2025-12-11 Buddhiheshan/aes core (#12)
    * updated the firmware code
    * updated testbenched
    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
    [tb_add_roundkey.sv, tb_decryption.sv, tb_encryption.sv, tb_mix_cols.sv, tb_pipeline_reg.sv, tb_shift_rows.sv, tb_sub_bytes.sv, tb_sub_bytes_inv.sv]
